Cwits/slr-gbox/docs/Architecture Overview/ArchCore.jpg

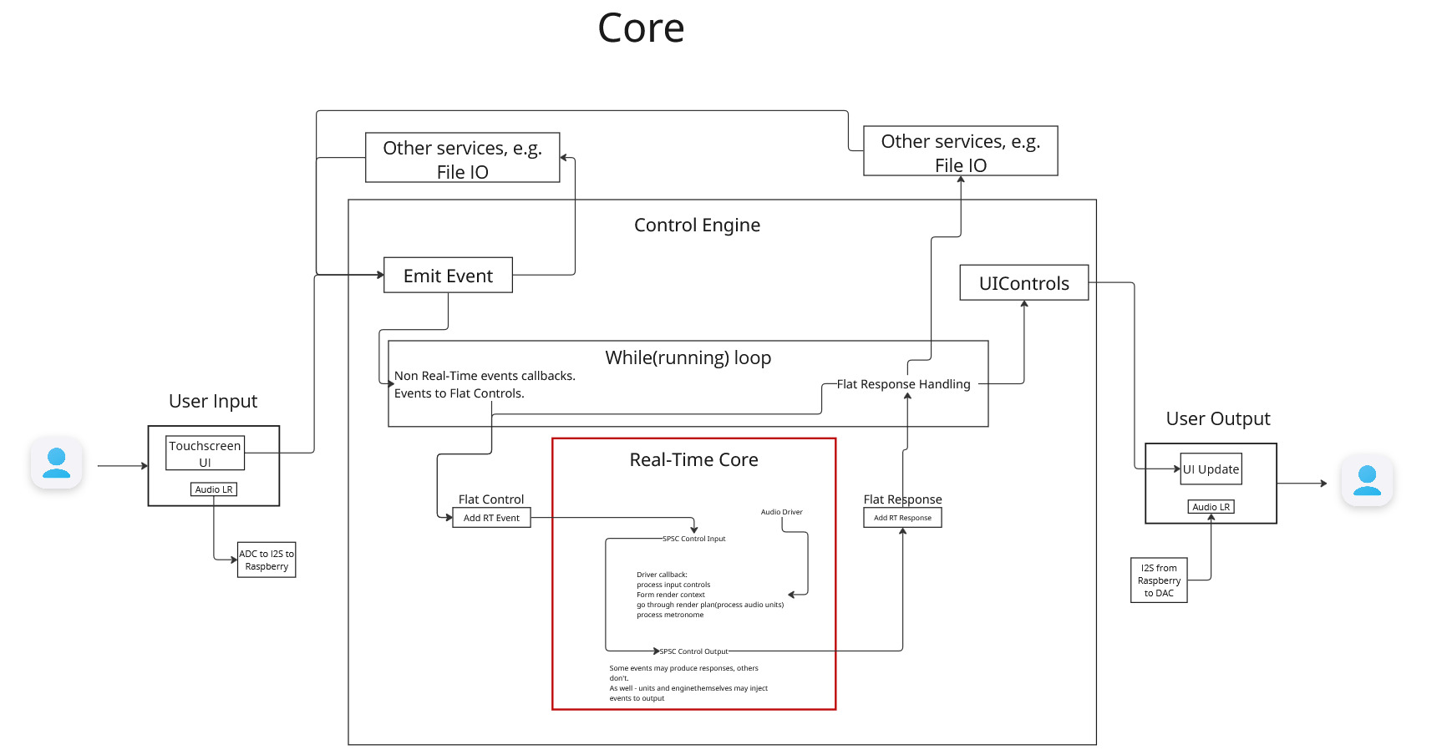
docs/Architecture Overview/ArchCore.jpg
