Cwits/slr-gbox/docs/Architecture Overview/ArchUI.jpg

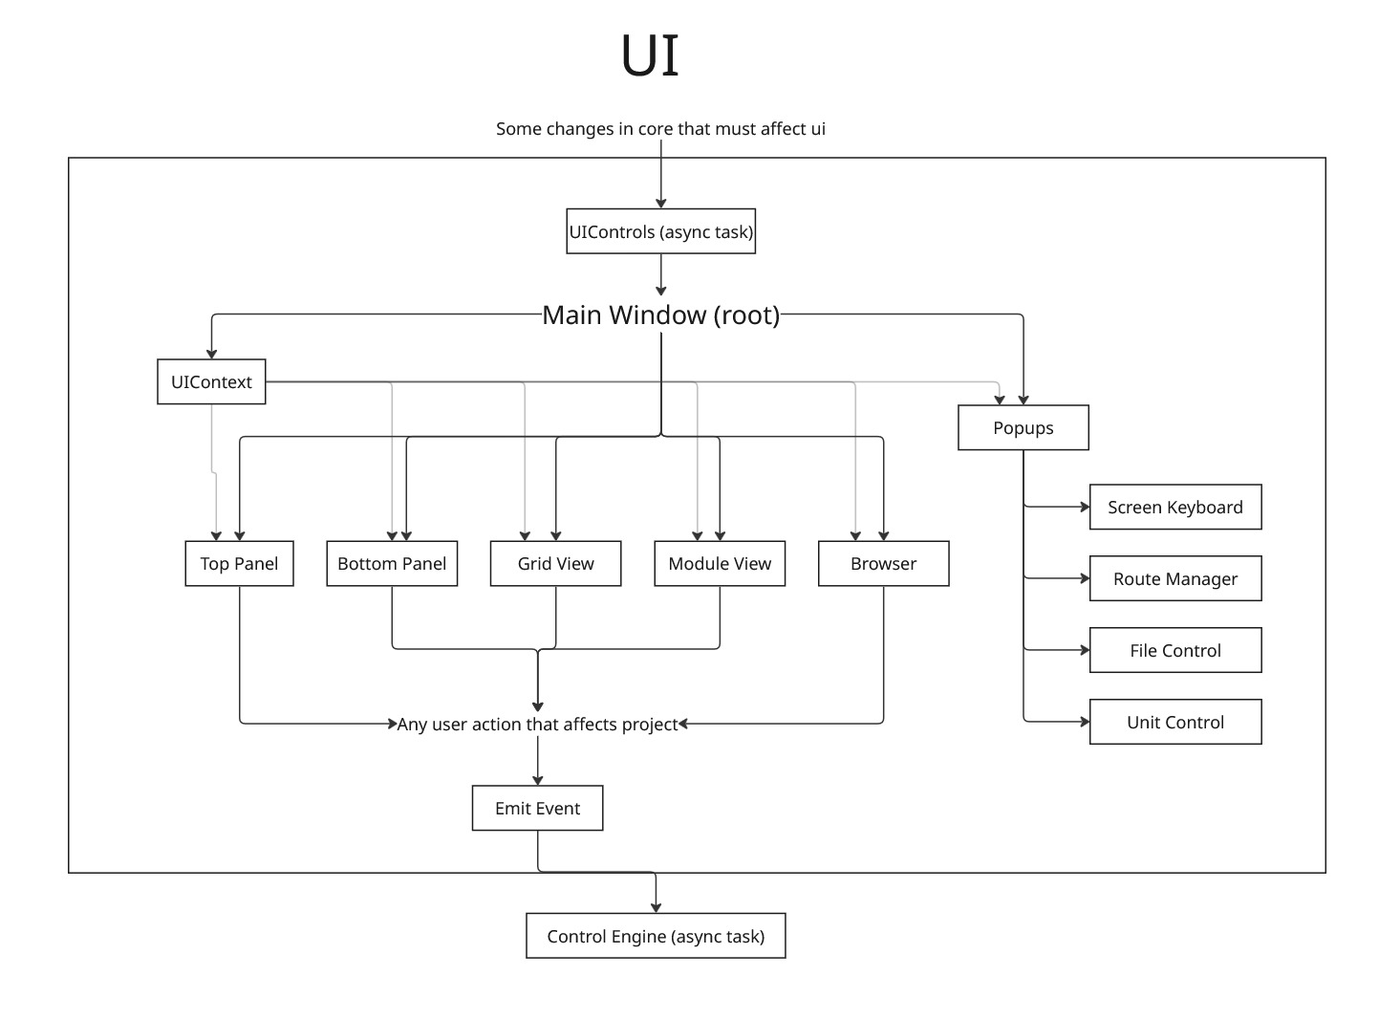
docs/Architecture Overview/ArchUI.jpg
