Cwits/slr-gbox/docs/pics/wiring_diagram.png

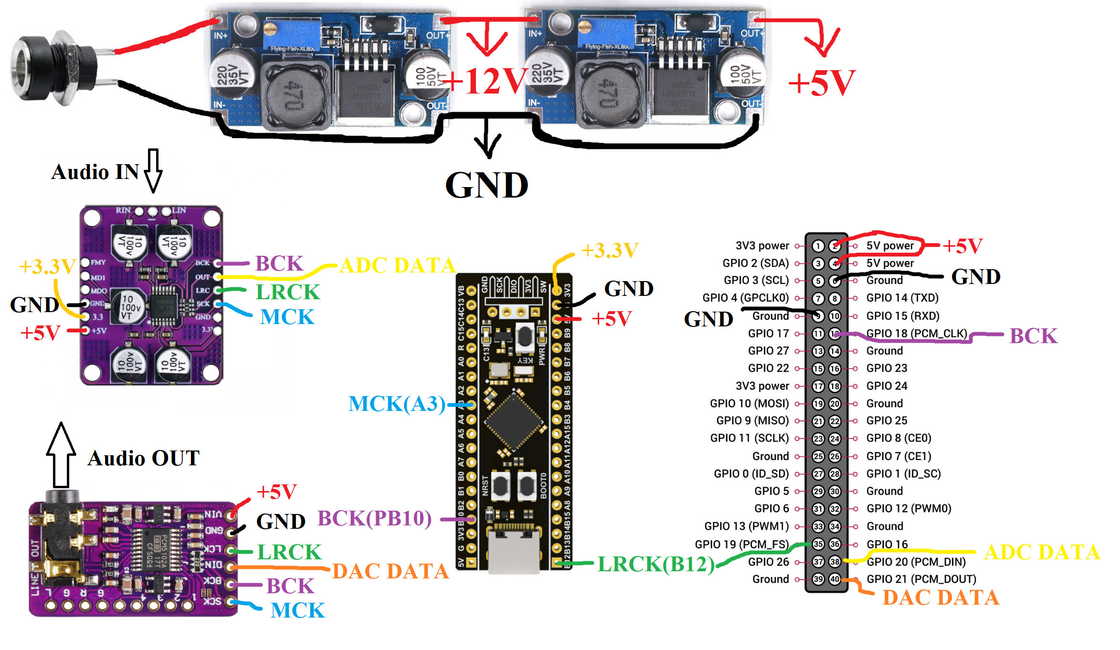
docs/pics/wiring_diagram.png
