Cwits/slr-gbox/docs/TODO.txt

/* Core */
Settings Manager:
[/] - implement simple settings manager that returns constants
    [x] - implement basic config file loading(not tested yet)
    [ ] - implement basic config file saving
    [ ] - implement original config file building(just in case if user deleted it) at SettingsManager.cpp:43 //build original
    [ ] - on loading not from original - must check that all options are presented(if no - use original) and values are valid

Control Engine:
[ ] - need to make fallback if track failed to delete because i'm deleting gui, and only than in rt engine(correct way), but if it's failed...
[ ] - make a loopback latency test function that will be called from settings.
        (call a function -> warning("make a loopback from output to input" OK/Cancle) -> test completing -> 
        popup with result -> "Result measured X samples latency" Apply/Cancle)
[x] - bit of rework for Events - have to make them get their own command id every time event fired(e.g. in EmitEvent())
        ...emmm... problem: RequestPlayheadPosition event from UI::MainWindow.cpp:372 backfires because of same commandId of flat event
        Done? now there is no need to assign ID manually - all is done in emitRtEvent(clt); function
        
Parameters: 
[\] - lil bit of rework. use std::vector instead of array, (use bool, int instead of using float everywhere... eeee...hz), (check in google drive)
        as soon as all the parameters are prepared in NRT and doesn't change dynamically - should be no problems
        Now list is a vector, not array

AudioUnit:
[ ] - make ::outputs() to give back not the AudioBuffer * but list of 
        struct Outputs {
                AudioBuffer * buf;
                std::string &name;
                int id;
        };
        so the user can have access to various stages of rendering(e.g. preFX, postFX, output)
        plus make ::output(id) to grant access to specific output for render plan builder
[ ] - make a virtual void reinit() = 0; member function that must be called every time when some fundamental settings are changed
        e.g. block size or sample rate or others.
[\] - ~~AudioUnit File Manipulation~~ rolled back, now only Track can load audio and midi files.
        [x] - Make FileContainer Part of AudioUnit, so all audio units can load audio and midi files
        [x] - Transfer playback logic from Track to AudioUnit,
        [x] - Transfer related to File Events from Track to AudioUnit(OpenFile, CloseFile)
        [\] - Make some config members as bool canLoadFile(type), AudioUnit::playbackFiles() abstraction, and ???
                canLoadFiles handled in UnitUIBase
        [ ] - Make unified logic for drawing files...
[ ] - In order to be able to inject midi events to AudioUnit they need some (current frame MidiBuffer) and small SPSCQueue...
        Injecting should work same way as MidiPort::pushEvent(...) in terms of frame calculating.
        (Current frame MidiBuffer - buffer where events for current frame will be stored and manipulated?)
[ ] - RemoveClip.h:118
        not deleting Clip and closing file totally.
        May add some reference counter to file and some kind of clean up process to close and free such memory.
        otherwise they stay in memory so user can reuse them quickly(need some kind of access procedure for it)

Metronome:
[\] - implement one(must live in rt class)(not tested)
[ ] - //TODO: add simple decay

Refactoring:
[x] - rewrite AudioBufferManager to namespace instead of singleton
[x] - FileWorker as a class 
[x] - rewrite ControlEngine to namespace instead of singleton ???
[x?] - instead of local in counters switch to one global id counter for all the entities.
        (not only for track, but for fx, mod engine, mixer, etc...)
[\] - move Track and Mixer out from core folder - to units folder, together with they ui's and other related stuff...
        (Track separated, mixer left)
        [ ] - create CMakeLists.txt for each module and add dynamic modules search in ModuleManager - 
        ... ugh, lvgl compiles as static library and need to recompile it with -fPIC in order to get everything as shared
[ ] - separate defines.h to two files - slr_config.h and common.h
[ ] - change SPSCQueue from compile-time size to runtime-size so it would be possible to edit count of regular and record buffers without recompiling code(check in google drive)
[ ] - Folder structure need bit of changes:
        [ ] - separate RT core from everything else(but than timeline should live in RT and not in project?)
                RT must become separate compilable entity?
                eee...
                PROFIT?!
        [ ] - primitives folder needs to be in inc/ but not in inc/core/ (1 layer higher)

[ ] - rewrite snapshots to some kind of subscribe model.??
        when some parameter changed and snapshots updated - call functions...?? 

RtEngine:
[ ] - ideally RtEngine should not know anything about Project. The RenderPlan can be stored in Project as std::unique_ptr, and passed as it happens now
        but what to do with timeline? should RtEngine own timeline, or Project(and pass together with render plan?)? Feels like first option be better...
        But if timeline stored in RtEngine than it would make things as prepareToPlay()\record() more difficult?

[ ] - must obrain buffers through MidiController. Basically - MidiController owning vectors:
        std::unique_ptr<std::vector<RtMidiBuffer>> and ... etc, rtengine just using them?

MidiController:
[ ] - MidiController.cpp:101 - //TODO: ugh, this is bad lol :D

Project:
[x] - make save and load system(serialization)
[ ] - make undo/redo system

Render Plan:
[x] - treat mixer as regular audio unit.
[x] - instead of mixer dependencies make output dependencies, so after processing all the units rt engine can do:
        TODO: RtEngine.cpp:150
        int mainoutsnum = plan->mainoutscount;
        for(int i=0; i<mainoutsnum; ++i) {
                for(frame_t f=0; f<ctx.frames; ++f) { 
                (*ctx.mainOutputs)[0][f] += (*plan->mainouts)[0][f];
                (*ctx.mainOutputs)[1][f] += (*plan->mainouts)[1][f];
                }
        }
        so, if there will be some units that will send directly to output - it will mix together
[ ] - implement settings checkbox "automatically update Render Plan on each new route" or smth
        so, if checked - render plan would be rebuilt every time new route(audio or midi) would be added.
        if unchecked - render plan would be updated only if user press specific button.(so can add bunch of routes and than update).
        (also, if unchecked than need some notifying icon to show up when new routes were added, but wasn't plan wasnt rebuilded)

Modules:
[ ] - Make a proper CMakeLists.txt template for easier to implement each module and not to edit main CMakeLists in order to add new one
[ ] - now modules registring in ModuleManager directly -> each module has to compile as dynamically linked libs - 
        .so and ModuleManager has to discover them automatically

Track Recording: 
[ ] - should prevent changing track record arm state if timeline is recording? or, at least, polish it somehow to make things nicer
        Thing that concerns me is that it looks bit messy right now? 
        because:
        RecordTarget::finalize() is called from two different places - one is when global record is stopped
                Event -> timeline::stopRecord() -> Project::stopAfterRecord() -> AudioUnit::stopRecording() -> Track::stopRecording() -> RecordTarget::stopRecord() -> RecordTarget::finalize()
        
        and another path is when Track's record arm is toggled to off state and finalize called though Track's Event(after record is off in RT):
                Event -> Track::setRecordArm() -> Response -> if(record == off) Track::releaseRecordTarget() -> RecordTarget::finalize() ...
        
        That's doesn't look right, must be reworked somehow

[ ] - MIDI recording isn't finished...

other:
[\] - introduce using ID = uint32_t(or uint64_t) so ID would be unified thing all across system
        partially - only in core and snapshots(not in UI)

/* UI: */
[ ] - make a function that can be called from anywhere. It should halt the system and pop up the window with "message" and await use action
        (e.g. when user trying to edit audio driver settings during playback pop the window "Playback will be stopped" and "Proceed" or "Cancle" buttons
                on "Proceed" pressed -> halt system, on "Cancle" -> go back as nothing happened
        or for any kind of errors appearing that user should be notified)
[\] - Fade out text message(also globally available) - \ added just show hide thing, no fade
[ ] - Floating text sometimes not appearing, and sometimes disappearing too fast
[ ] - //TODO: this + after map is odd... need to fix it in FileView::draw()
[ ] - periodically updates need different algorithm, see TODO in postToLvgl
[ ] - in uiControls.cpp postToLvgl() with lambdas will cause memory fragmentation.
[\] - //sometimes visible() failed because of nullptr lvhost?? MainWindow.cpp::hitTest()::if(!child->visible())
        in route manager it was because of duplicating pointers(not deleting from childrens), now BaseWidget deleting itself from parent->childs() on delete
        but not sure that was the case.
[ ] - Popup should be activated through MainWindow::activatePopup, but not through popup::activate(), popup::show().
        for better control and etc. 
        Should modules add popups by themselves?
[ ] - Must somehow move to modular view, without that much coupling...
[ ] - Abstract GridControl UI for modules to have basic grid control with files
[ ] - in MainWindow::transferGesture() you can't use getSwitchViewTarget(at least for grid)
        because in case of switching from browser to grid during drag(transfer gesture) 
        target should be _gridView->_grid
        simply - need some destination dispatcher during drag event

Route Manager:
[ ] - channel mapping
[ ] - removing route
[ ] - "Omni HW Input" checkbox confuses. What is that - omni midi input or omni audio input?

Browser:
[ ] - Browser TODO: show selector that will allow to select where we want to drag.
            that means we have to make transferGesture to selector and than from selector
            make another transfer to destination(if released on empty space than drom gesture)

Drop Down Menu:
[ ] - DropDown widget to handle swipe, to check how much space left for list, render above.
[x] - DropDown widget failing when "index is 3, vector size is 2" - now position calculating in absolute values

[ ] - guiThread must provide function to add ui update tasks to schedule, so it be simple to call from uiControls.cpp

Screen Keyboard:
[ ] - make a Shift functional
[ ] - make clear button(erase all text)

/* Other */
CMakeLists and EvGen
[ ] - modify cmakelists.txt to use strict file sources list for compiling, not recursive serach
[ ] - after cmake mod - move template files from evgen folder to regular inc/src folders and modify evgen to parse them
[ ] - EvGen not working properly with <moduleEventsGen.h> files that aren't located in src/core folder
[ ] - Clear and structurize CMakeFile better :S
[ ] - IMPORTANT!!! need to stabilize naming convention - either all parts(track, mixer, sampler, whatever will be called Module or Unit...)
                ugh... :\

Tests:
[ ] - tests for Control Engine
[ ] - tests for SettingsManager
[ ] - AudioBufferManager tests not working anymore(due to changes in acquireRecordBuffer)
[ ] - make proper stacktrace record on fatal error's and logging to file
[ ] - sometimes app crashes on startup or shutdown... 
[ ] - sometimes SDL doesn't catch QUIT signal when exit via X in right top corner
[ ] - FakeGestures doesn't allways handle events in time, but some sort of delayed handle...

[ ] - more tests!
[ ] - more logging!

[ ] - there is several memory leaks in ui...?

Push:
[ ] - don't understand how reconnect suppose to work...
        at some time point all of midi in/midi out/display will return false
        meaning that device is disconnected... -> ??
        how to reconnect??
        Relates to generic midi as well???

[ ] - MidiInterface::handleEvent...
        //TODO: the other's important CC will be here as well - e.g. sustain pedal... smth else?

[ ] - you want to somehow make _buttonCallbackMap of widgets not an std::map, but std::array<> or smth... to make search time less consuming...
[\] - BIG REWORK-UPDATE: need some proper retained UI logic... (similar to lvgl?) to redraw only affected areas and save some cpu...
        [x] - very basic implementation of retained logic
        [ ] - PushDisplay::updateFrame(BoundingBox &boxToUpdate); encoding whole frame instead of boxToUpdate
        [ ] - Sometimes, when things moving quickly - old position struggle to clear
                (e.g. with Pointer in PadLayoutWidget - sometimes old pointer stays there)
        [ ] - PushPainter drawing algos can be optimised more?
        [ ] - if Label (or StaticLabel?) overlaps with some moving element than text might drift

/* Notes */
 - As soon as every unit can handle files(especially MIDI files) to prevent midi flooding in long chains of units - 
        all MIDI events that reaches specific unit won't be able to travel to unit output(doesn't matter if it's 
        from external device or from MIDI Clip). To enable MIDI Events to travel further "Midi Thru" should be enabled for 
        specific unit.

        e.g.
        MIDI Clip is on whatever unit. 
        Without "Midi Thru" enabled MIDI Events will affect only that unit, and not appear in _midiOutput buffer of that unit.
        (doesn't matter if there is some MIDI routings from unit to somewhere(dunno yeat about routings to external devices)).
        With "Midi Thru" option enabled MIDI Events will affect unit and go to _midiOutput buffer of that unit. So, if there is 
        any MIDI routings from unit to somewhere else than those events can be grabbed on that frame.

        struct FileOpenedNew : public Undoable {
    Status status;
    File * file; //-> class File;
	ID unitId;

	void undo() {
		if(status == Status::Nok) return;

		Events::RemoveFile e = {
			.fileId = file->id(),
			.unitId = unitId
		};
		Events::EmitEvent(e);
	}
};
