Cwits/slr-gbox/docs/devlog.txt

14.01.25
... sooo... long time... 
i don't like AudioBufferManager thing... have to move that to more generalized BufferManager, that will remain as namespace
but provide options for MidiBuffers, than recording midi will be possible.
but need to figure out flow of midi 

13.11.25
Added lower and upper case in screen keyboard

03.11.25
hittest now works by sorting by Z index of objects

31.10.25
Added primitive Slider UI to mixer so all connected modules volume can be adjusted from mixer.
File loading and drawing on grid moved to UnitUIBase, now all modules can load and playback audio files

22.10.25
Updated Route Manager to be able internal connections as well.
Added Mixer module.
Updated Render Plan builder to handle more complex routings. 
Removed Mixer from Render Plan, now there is output dependencies, that mixed in RtEngine as last step.
For now only linear, without interconnections.
e.g. 
EXT IN -> Track1 -> Mixer -> EXT OUT
          Track2 -> Mixer -> EXT OUT
          Track3 ->       -> EXT OUT

17.10.25
Added abstract "CreateModule" event with name parameter.
Added Basic Mixer Unit implementation
