Cwits/slr-gbox/src/push/PushFonts.cpp

#include "push/PushFonts.h"

#include <cstdint>

namespace PushLib {

static const uint16_t Font6x8 [] = {
0x0000, 0x0000, 0x0000, 0x0000, 0x0000, 0x0000, 0x0000, 0x0000,  // sp
0x2000, 0x2000, 0x2000, 0x2000, 0x2000, 0x0000, 0x2000, 0x0000,  // !
0x5000, 0x5000, 0x5000, 0x0000, 0x0000, 0x0000, 0x0000, 0x0000,  // "
0x5000, 0x5000, 0xf800, 0x5000, 0xf800, 0x5000, 0x5000, 0x0000,  // #
0x2000, 0x7800, 0xa000, 0x7000, 0x2800, 0xf000, 0x2000, 0x0000,  // $
0xc000, 0xc800, 0x1000, 0x2000, 0x4000, 0x9800, 0x1800, 0x0000,  // %
0x4000, 0xa000, 0xa000, 0x4000, 0xa800, 0x9000, 0x6800, 0x0000,  // &
0x3000, 0x3000, 0x2000, 0x4000, 0x0000, 0x0000, 0x0000, 0x0000,  // '
0x1000, 0x2000, 0x4000, 0x4000, 0x4000, 0x2000, 0x1000, 0x0000,  // (
0x4000, 0x2000, 0x1000, 0x1000, 0x1000, 0x2000, 0x4000, 0x0000,  // )
0x2000, 0xa800, 0x7000, 0xf800, 0x7000, 0xa800, 0x2000, 0x0000,  // *
0x0000, 0x2000, 0x2000, 0xf800, 0x2000, 0x2000, 0x0000, 0x0000,  // +
0x0000, 0x0000, 0x0000, 0x0000, 0x3000, 0x3000, 0x2000, 0x0000,  // ,
0x0000, 0x0000, 0x0000, 0xf800, 0x0000, 0x0000, 0x0000, 0x0000,  // -
0x0000, 0x0000, 0x0000, 0x0000, 0x0000, 0x3000, 0x3000, 0x0000,  // .
0x0000, 0x0800, 0x1000, 0x2000, 0x4000, 0x8000, 0x0000, 0x0000,  // /
0x7000, 0x8800, 0x9800, 0xa800, 0xc800, 0x8800, 0x7000, 0x0000,  // 0
0x2000, 0x6000, 0x2000, 0x2000, 0x2000, 0x2000, 0x7000, 0x0000,  // 1
0x7000, 0x8800, 0x0800, 0x7000, 0x8000, 0x8000, 0xf800, 0x0000,  // 2
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
};

Font Font_6x8 = {6,8,Font6x8};
Font Font_7x10 = {7,10,Font7x10};
Font Font_11x18 = {11,18,Font11x18};
Font Font_16x26 = {16,26, Font16x26};

}
