Cwits/slr-gbox/inc/push/Color.h

// SPDX-FileCopyrightText: 2025 Cwits
// SPDX-License-Identifier: GPL-3.0-or-later
#pragma once

#include <cstdint>
#include <string>
#include <vector>
#include "common/Color.h"

namespace PushLib {

using Color = uint16_t;
using Pixel = uint16_t;

namespace Colors {
    constexpr Color Black   = 0x0000;
    constexpr Color Red     = 0x001F;
    constexpr Color Green   = 0x07E0;
    constexpr Color Blue    = 0xFFE0;
    constexpr Color White   = 0xFFFF;
}

// inline Color rgb(int r, int g, int b) {
//     uint16_t tmpr, tmpg, tmpb;
//     tmpr = tmpg = tmpb = 0;

//     if(r>0) tmpr = 0 + (float)((float)(0x001F-0)/(float)(255-0)) * (r - 0);
//     if(g>0) tmpg = 0x001F + (float)((float)(0x07E0 - 0x001F)/(float)(255-0)) * (g - 0);
//     if(b>0) tmpb = 0x07E0 + (float)((float)(0xF800 - 0x07E0)/(float)(255-0)) * (b - 0);

//     return tmpr | tmpg | tmpb;
// }

inline Color rgb(int r, int g, int b) {
    uint16_t tmpr, tmpg, tmpb;

    tmpr = (r * 31 / 255) & 0x1F;
    tmpg = (g * 63 / 255) & 0x3F;
    tmpb = (b * 31 / 255) & 0x1F;

    return (tmpb << 11) | (tmpg << 5) | tmpr;
}

inline Color rgb(slr::Color color) {
    return rgb(color.r, color.g, color.b);
}

inline Color invert(Color color) { return (color ^ 0xFFFF); }

inline Color random() {
    return rgb(rand()%255, rand()%255, rand()%255);
}

using SysexMsg = std::vector<unsigned char>;

}
