Cwits/slr-gbox/src/push/PushSysex.cpp

// SPDX-FileCopyrightText: 2025 Cwits
// SPDX-License-Identifier: GPL-3.0-or-later

#include "push/PushSysex.h"

namespace PushLib {

PushSysex::PushSysex(PushMidi &midi) : _midi(midi) {

}

PushSysex::~PushSysex() {

}

void PushSysex::registerCmdWithReply(unsigned char command) {

}

void PushSysex::handle(SysexMsg &msg) {

}

    
}
