Cwits/slr-gbox/inc/evgen_defines.h

// SPDX-FileCopyrightText: 2025 Cwits
// SPDX-License-Identifier: GPL-3.0-or-later

#pragma once

#define EVGEN_EVSTART
#define EVGEN_EVEND

#define EVGEN_RESPSTART
#define EVGEN_RESPEND

#define EVGEN_CONTROL_EVENTS_HANDLE
#define EVGEN_CONTROL_EVENTS_RESPONSES

#define EVGEN_RT_EVENTS_HANDLE
