Cwits/slr-gbox/src/defines.cpp

// SPDX-FileCopyrightText: 2025 Cwits
// SPDX-License-Identifier: GPL-3.0-or-later

#include "defines.h"
#include "core/ControlEngine.h"
#include "snapshots/ProjectView.h"
#include "snapshots/TimelineView.h"

#include "logger.h"

#include <cmath>
