Cwits/slr-gbox/inc/ui/display/PopupManager.h

// SPDX-FileCopyrightText: 2025 Cwits
// SPDX-License-Identifier: GPL-3.0-or-later

#pragma once

#include <functional>
#include <string>
#include "defines.h"

namespace UI {

class BaseWidget;
class UnitUIBase;
class UnitControlPopup;
class RouteManager;
class TimelinePopup;
class ScreenKeyboard;
class FilePopup;
class FileView;
class NewUnitPopup;
class SettingsPopup;
class VirtualMidiKeyboard;
class DragViewSelector;

struct PopupManager {
    PopupManager();
    ~PopupManager();

    TimelinePopup * _timelinePopup;

    void enableKeyboard(std::string initialText, 
                    std::function<void(const std::string &text)> finishCallback);
    void disableKeyboard();

    void enableUnitControl(UnitUIBase * unit, BaseWidget * parent);
    void disableUnitControl();

    void enableRouteManager(slr::ID unitId);
    void disableRouteManager();

    void enableFilePopup(FileView * file);
    void setFilePopupPosition(int x, int y);
    void disableFilePopup();

    void enableNewUnitPopup();
    void disableNewUnitPopup();

    void enableSettingsPopup();
    void disableSettingsPopup();

    void enableMidiKeyboard();
    void disableMidiKeyboard();

    void enableDragSelector();
    void disableDragSelector();
    
    private:
    UnitControlPopup * _unitControlPopup;
    ScreenKeyboard * _screenKeyboard;
    RouteManager * _routeManager;
    FilePopup * _filePopup;
    NewUnitPopup * _newUnitPopup;
    SettingsPopup * _settingsPopup;
    VirtualMidiKeyboard * _virtualMidiKeyboard;
    DragViewSelector * _dragViewSelector;

    friend class MainWindow;
};

}
