Cwits/slr-gbox/inc/ui/display/defaultColors.h

// SPDX-FileCopyrightText: 2025 Cwits
// SPDX-License-Identifier: GPL-3.0-or-later

#pragma once

#include "lvgl.h"

namespace UI {

extern const lv_color_t RED_COLOR;
extern const lv_color_t GREEN_COLOR;
extern const lv_color_t BLUE_COLOR;
extern const lv_color_t YELLOW_COLOR;
extern const lv_color_t WHITE_COLOR;
extern const lv_color_t BLACK_COLOR;
extern const lv_color_t GRAY_COLOR;

extern const lv_color_t BUTTON_DEFAULT_PRESSED;
extern const lv_color_t BUTTON_DEFAULT_COLOR;

extern const lv_color_t MUTE_ON_COLOR;
extern const lv_color_t MUTE_OFF_COLOR;

extern const lv_color_t PLAY_ON_COLOR;
extern const lv_color_t PLAY_PAUSE_COLOR;

extern const lv_color_t REC_ON_COLOR;

extern const lv_color_t LOOP_ON_COLOR;

extern const lv_color_t METRONOME_ON_COLOR;

extern const lv_color_t FLOATING_TEXT_REGULAR_COLOR;
extern const lv_color_t FLOATING_TEXT_WARNING_COLOR;

/* Background colors */
extern const lv_color_t KEYBOARD_BACKGROUND_COLOR;

}
