Cwits/slr-gbox/(commit log)

2026-02-28 pads, leds, display, no sysex
2026-03-06 encoders works
2026-03-09 some progress on buttons
2026-03-10 keep working on button logic
2026-03-10 some more work on button logic
2026-04-03 sampler base and improving arch
2026-05-03 forgot Track actions
2026-05-23 Timeline loading as well, need to add extra step for sample rate and block size. Added drag target selector, route manager can be switched targets by it's own
2026-05-24 push fix forgotten action
    [PushMidi.cpp]
2026-06-04 stm32 fimware separated to another repository
